AERPAW/AMP-Interface/README.md

# AMP-Interface
The AERPAW Multi-Purpose (AMP) Interface is an electromechanical standard for connecting payloads and batteries to all vehicles in the AERPAW fleet.

NOT COMPLETE
