AERPAW/AMP-Interface/Connector PCBs/Basic Battery Side Connector/Battery PCB.DXF

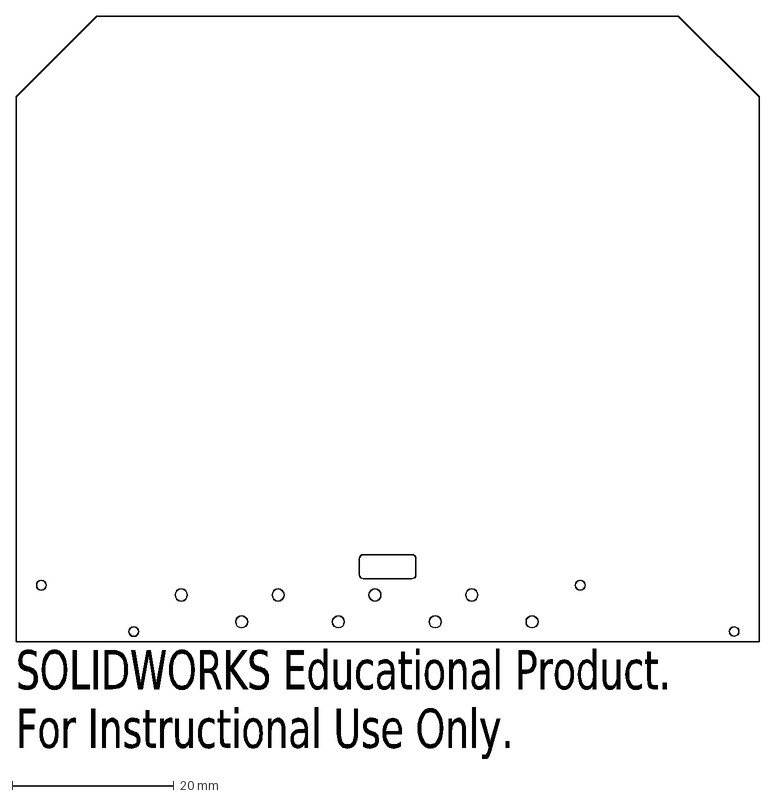
[picture p1: CAD file, 2023-02-27]
Connector PCBs/Basic Battery Side Connector/Battery PCB.DXF
SOLIDWORKS Educational Product.
For Instructional Use Only.
