AERPAW/AMP-Interface/Connector PCBs/vehicle side connector/Drone Side Card Edge Connector Outline.DXF

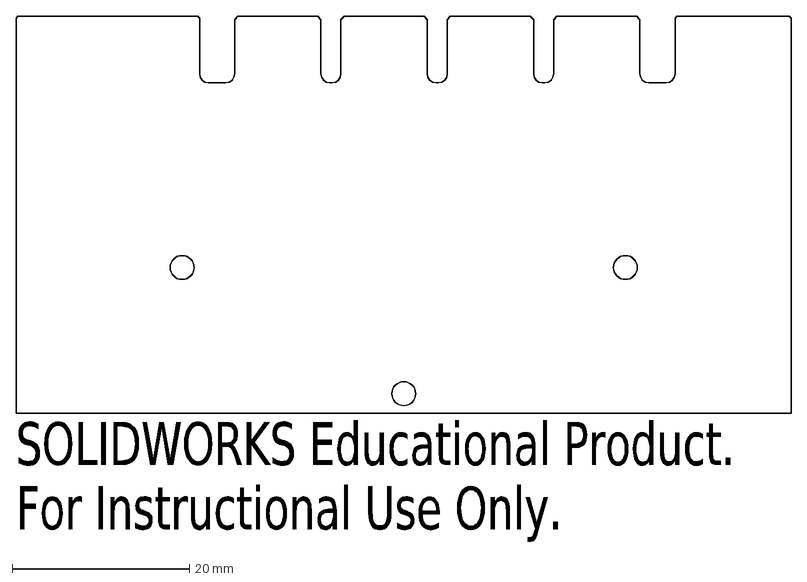
[picture p2: CAD file, 2023-02-14]
Connector PCBs/vehicle side connector/Drone Side Card Edge Connector Outline.DXF
SOLIDWORKS Educational Product.
For Instructional Use Only.
