AERPAW/AMP-Interface/(list of files, cad)

Other CAD files:
Mechinical Interface/vehicle side connector.SLDASM
Mechinical Interface/vehicle side connector1.SLDASM
Battery Example/Battery Interface PCB.SLDASM
Battery Example/Battery and Mount.SLDASM
Mechinical Interface/User Library-XT90PB-F.SLDASM
Mechinical Interface/Slide & Lock Asm.SLDASM
Mechinical Interface/AMASS_XT60-F_1x02_P7.2mm_Vertical.SLDASM
Mechinical Interface/R_2512_6332Metric.SLDASM
Battery Example/PinSocket_1x07_P2.54mm_Horizontal.SLDASM
Mechinical Interface/R_1206_3216Metric.SLDASM
Battery Example/Batt Cage v3.SLDASM
Battery Example/CF base plate.SLDPRT
Connector PCBs/Basic Payload Connector/Basic Payload Connector/Basic Payload Connector.step
Connector PCBs/vehicle side connector/vehicle side connector.step
Manufacturing Files/Lock Leaver_Mirrored.3MF
Manufacturing Files/Lock Leaver.3MF
Battery Example/Battery PCB.SLDPRT
Mechinical Interface/SOLID_3.SLDPRT
Connector PCBs/3D Models/User Library-XT90PB-F.step
Mechinical Interface/SOLID.SLDPRT
Mechinical Interface/COMPOUND_2.SLDPRT
Battery Example/CF Side Plate.SLDPRT
Battery Example/upper support rail.SLDPRT
Mechinical Interface/SOLID_2.SLDPRT
Mechinical Interface/vehicle side connector PCB.SLDPRT
Battery Example/support rail.SLDPRT
Battery Example/SOLID.SLDPRT
Mechinical Interface/COMPOUND.SLDPRT
Battery Example/COMPOUND.SLDPRT
Mechinical Interface/Lock Leaver_Mirrored.SLDPRT
Mechinical Interface/CNC AL Slot Bracket.SLDPRT
Battery Example/Part10.SLDPRT
Mechinical Interface/Lock Leaver.SLDPRT
Battery Example/Battery Interface PCB PCB.SLDPRT
Battery Example/COMPOUND_2.SLDPRT
Battery Example/CF Top Plate.SLDPRT
Battery Example/461120801.SLDASM
Battery Example/461120801.stp
Battery Example/461130201.SLDASM
Battery Example/461130201.stp
Battery Example/461130321.stp
Battery Example/92832A173_Zinc-Plated Alloy Steel Button Head Torx Screws.SLDPRT
Battery Example/92832A176_Zinc-Plated Alloy Steel Button Head Torx Screws.SLDPRT
Battery Example/92832A564_Zinc-Plated Alloy Steel Button Head Torx Screws.SLDPRT
Connector PCBs/3D Models/461120801.stp
Connector PCBs/3D Models/461130201.stp
Connector PCBs/3D Models/461130321.stp
Connector PCBs/3D Models/5031542290.stp
Mechinical Interface/5031542290.SLDASM
Mechinical Interface/Fasterners & Hardware/91273A321_Same-Size Thread 18-8 Stainless Steel Shoulder Screw.SLDPRT
Mechinical Interface/Fasterners & Hardware/9657K257_Compression Spring.SLDPRT
