AERPAW/AMP-Interface/Connector PCBs/Basic Battery Side Connector/Battery Interface PCB/Battery Interface PCB.kicad_pcb

## KiCad design Connector PCBs/Basic Battery Side Connector/Battery Interface PCB/Battery Interface PCB.kicad_pcb (2023-02-27)

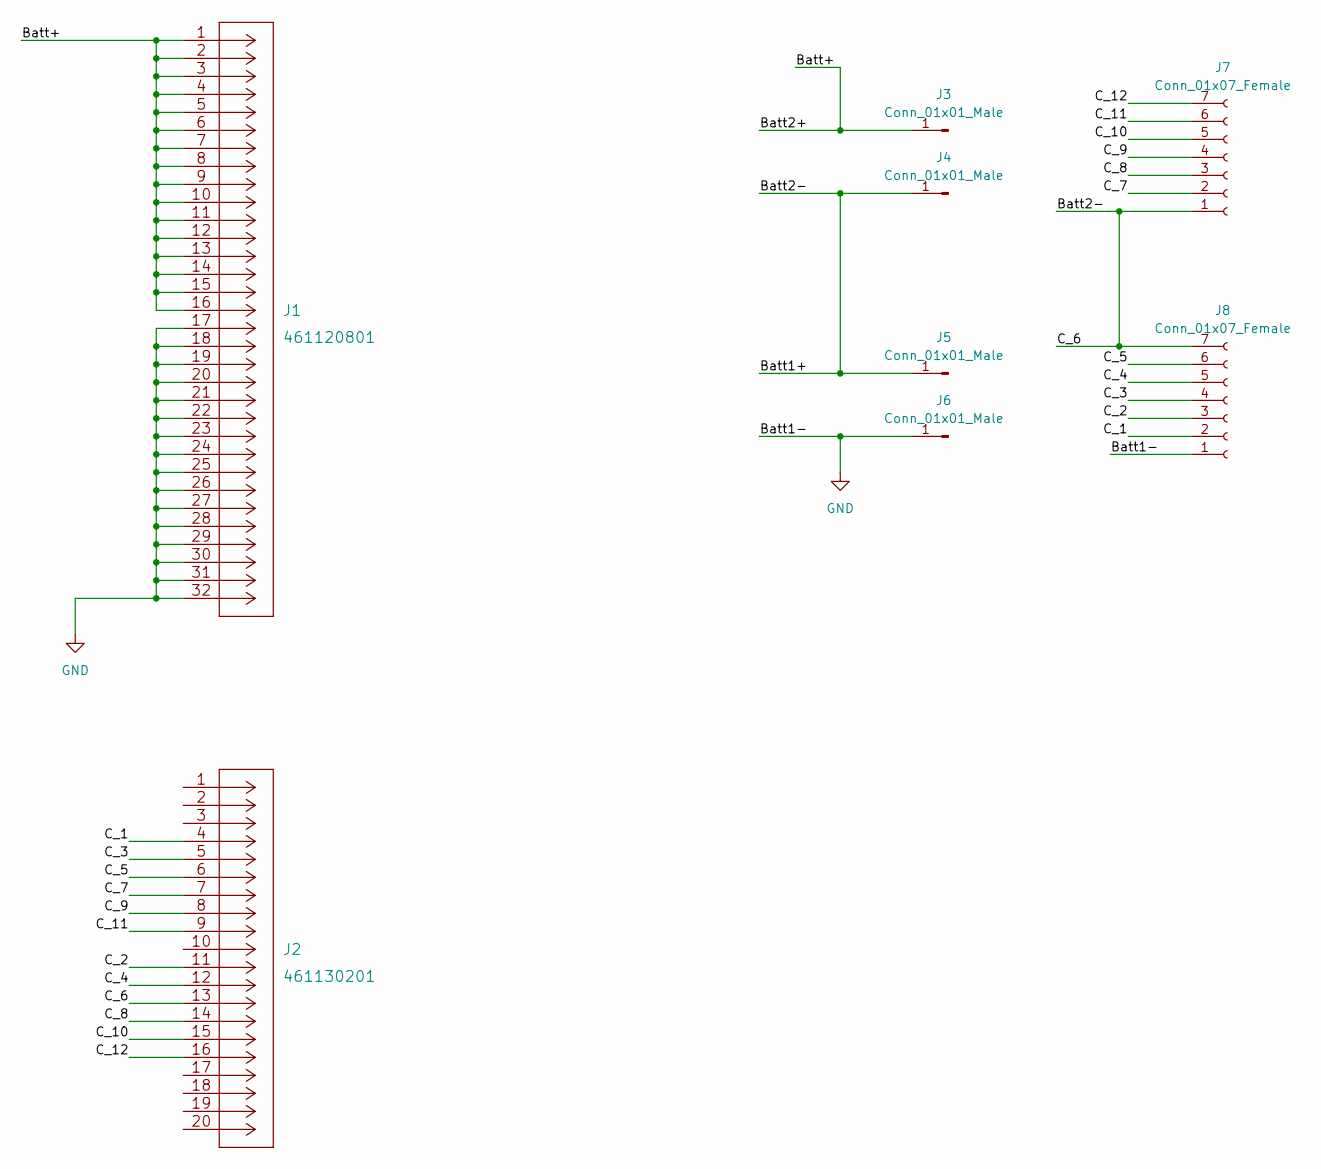
[picture p6: schematic Battery Interface PCB.kicad_sch]

Parts:
J1: 461120801
J2: 461130201
J3, J4, J5, J6: Conn_01x01_Male; 8x12 Wire landing
J7, J8: Conn_01x07_Female; PinSocket_1x07_P2.54mm_Horizontal

Connections:
/Batt2-: J2.13, J4.1, J5.1, J7.1, J8.7
/Batt+: J1.1, J1.2, J1.3, J1.4, J1.5, J1.6, J1.7, J1.8, J1.9, J1.10, J1.11, J1.12, J1.13, J1.14, J1.15, J1.16, J3.1
/C_1: J2.4, J8.2
/C_2: J2.11, J8.3
/C_3: J2.5, J8.4
/C_4: J2.12, J8.5
/C_5: J2.6, J8.6
/C_7: J2.7, J7.2
/C_8: J2.14, J7.3
/C_9: J2.8, J7.4
/C_10: J2.15, J7.5
/C_11: J2.9, J7.6
/C_12: J2.16, J7.7
GND: J1.17, J1.18, J1.19, J1.20, J1.21, J1.22, J1.23, J1.24, J1.25, J1.26, J1.27, J1.28, J1.29, J1.30, J1.31, J1.32, J6.1, J8.1

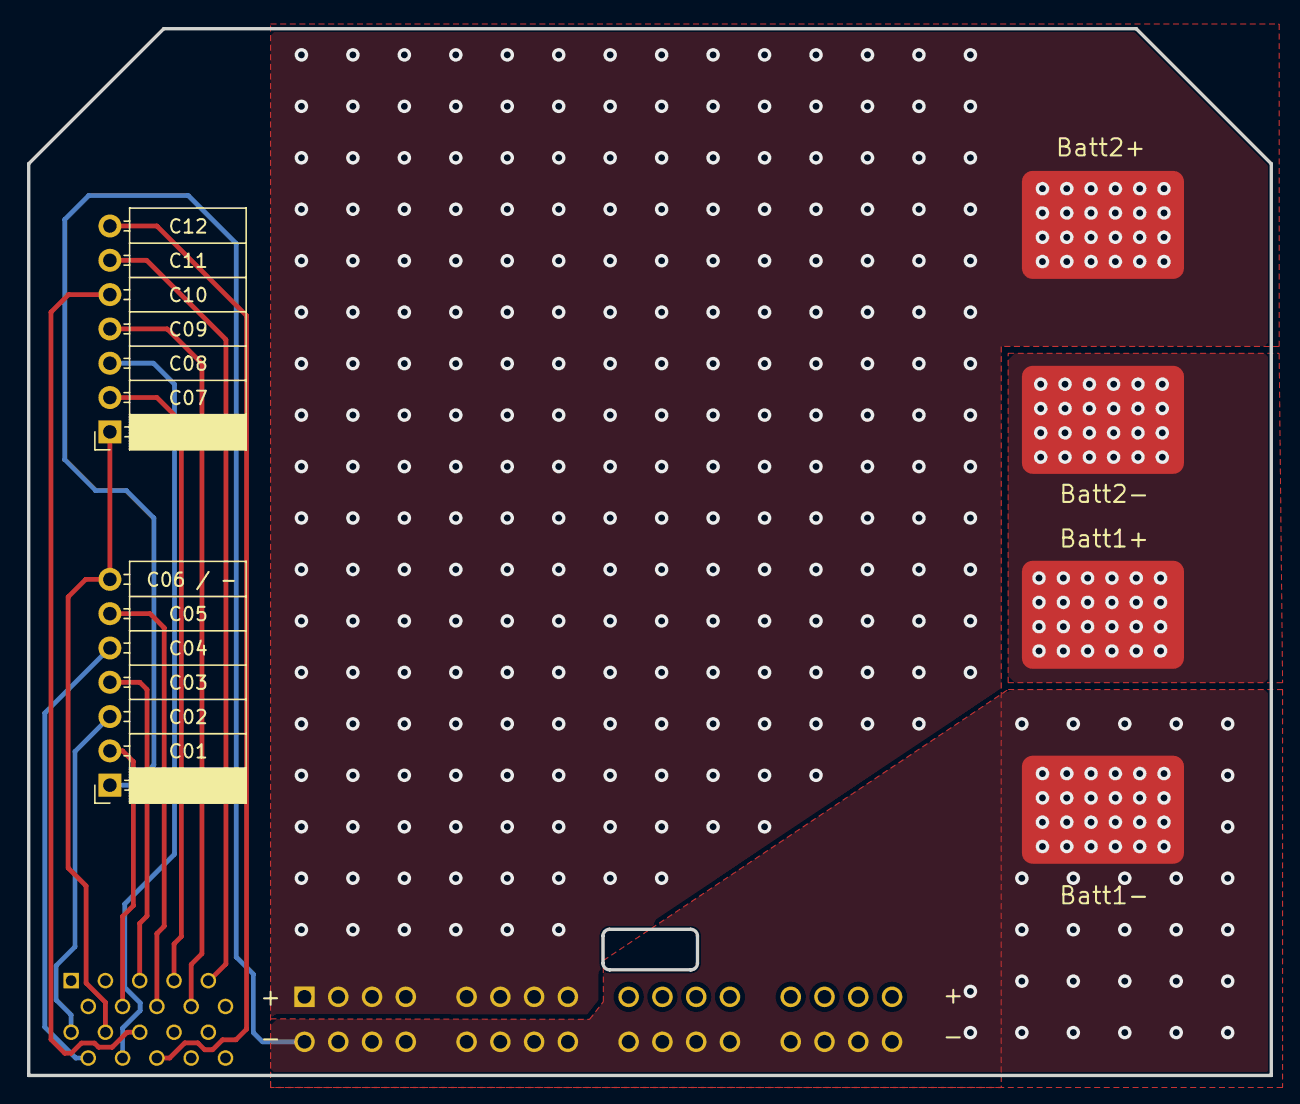
[picture p7: board Battery Interface PCB.kicad_pcb from above]

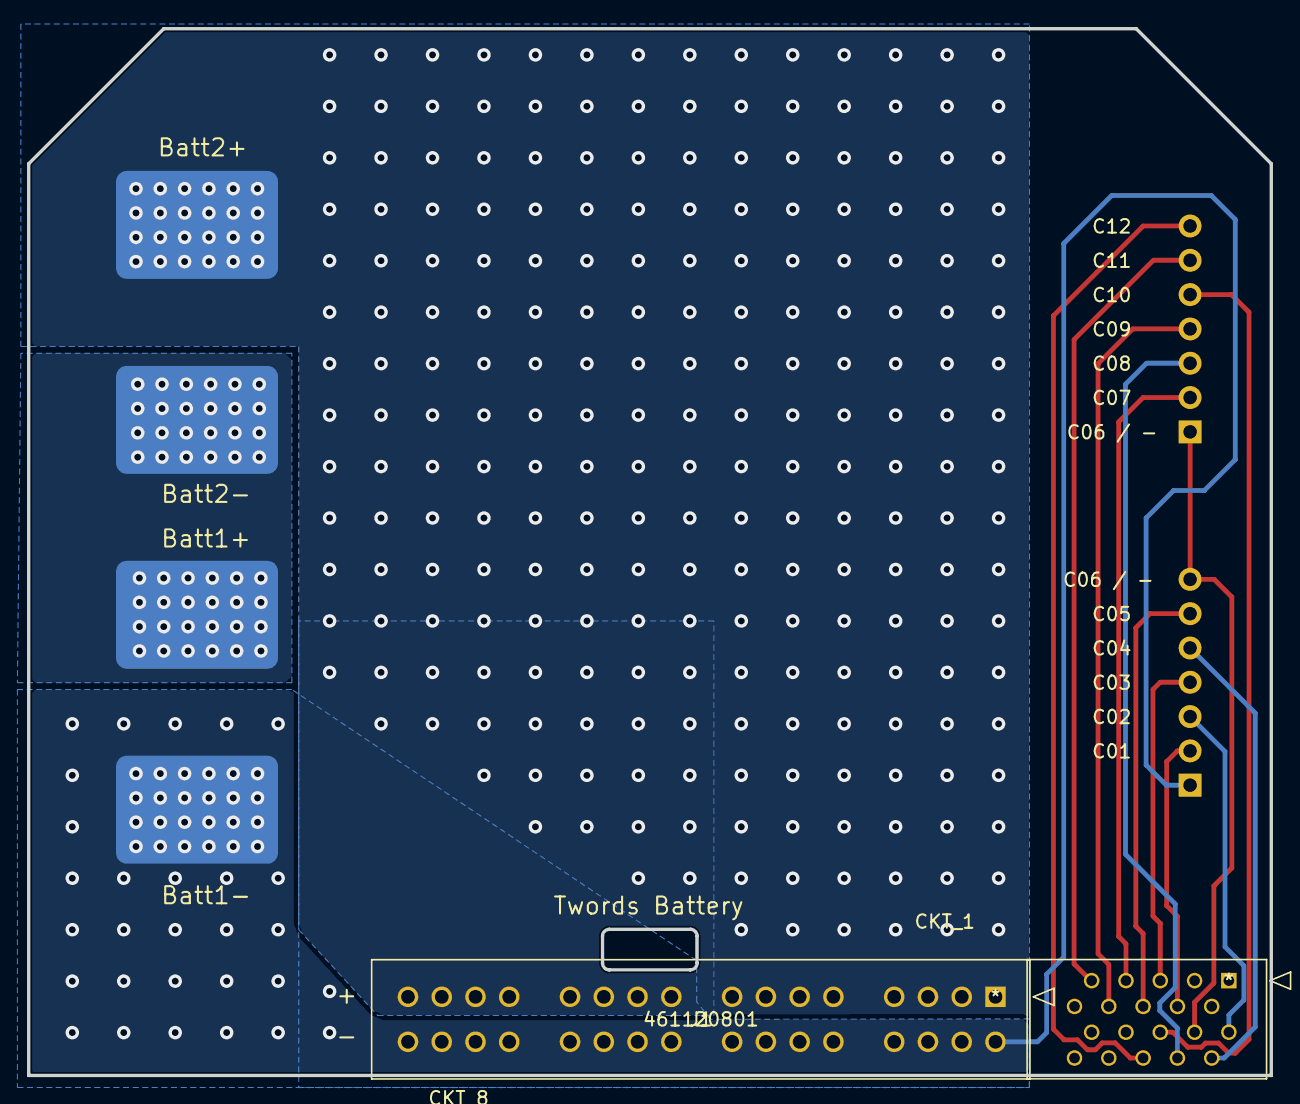
[picture p8: board Battery Interface PCB.kicad_pcb from below]

Board: 2 copper layers, 92.0 x 77.5 mm, 8 parts (6 on the bottom side), 14 nets.
