AERPAW/AMP-Interface/(commit log)

2023-02-13 inital commit with basic structure
    [vehicle side connector.kicad_pcb, vehicle side connector.kicad_sch]
2023-02-14 added connectors and pinout to schematics, imported board outline
    [Drone Side Card Edge Connector Outline.DXF, vehicle side connector.kicad_pcb, vehicle side connector.kicad_sch]
2023-02-14 added card edge footprints and updated detect pin in schmeatic
    [vehicle side connector.kicad_pcb, vehicle side connector.kicad_sch]
2023-02-22 testing why the mechanical stuff isnt added
    [5031542290.SLDASM, 5031542290.stp, 91273A321_Same-Size Thread 18-8 Stainless Steel Shoulder Screw.SLDPRT, 9657K257_Compression Spring.SLDPRT, AMASS_XT60-F_1x02_P7.2mm_Vertical.SLDASM, CNC AL Slot Bracket.SLDPRT, COMPOUND.SLDPRT, COMPOUND_2.SLDPRT]
2023-02-27 completed drone side connector PCB
    [5031542290.SLDASM, AMASS_XT60-F_1x02_P7.2mm_Vertical.SLDASM, COMPOUND.SLDPRT, COMPOUND_2.SLDPRT, R_1206_3216Metric.SLDASM, R_2512_6332Metric.SLDASM, SOLID.SLDPRT, SOLID_2.SLDPRT]
2023-02-27 fixed minor clearnace issue on inner layers, kicad rounding error
    [vehicle side connector-B_Cu.gbr, vehicle side connector-B_Mask.gbr, vehicle side connector-B_Paste.gbr, vehicle side connector-B_Silkscreen.gbr, vehicle side connector-Edge_Cuts.gbr, vehicle side connector-F_Cu.gbr, vehicle side connector-F_Mask.gbr, vehicle side connector-F_Paste.gbr]
2023-02-27 Added CAD for sizing battery side interface PCB, completed PCB
    [461120801.SLDASM, 461120801.stp, 461130201.SLDASM, 461130201.stp, 461130321.stp, 92832A173_Zinc-Plated Alloy Steel Button Head Torx Screws.SLDPRT, 92832A176_Zinc-Plated Alloy Steel Button Head Torx Screws.SLDPRT, 92832A564_Zinc-Plated Alloy Steel Button Head Torx Screws.SLDPRT]
2023-02-28 finished basic payload connector PCB
    [Basic Payload Connector.kicad_pcb, Basic Payload Connector.kicad_sch, Basic Payload Connector.step]
